Jophish/YM2612-Synth/YM2612/Ym2612.sch

## EAGLE design YM2612/Ym2612.sch (2020-07-03)

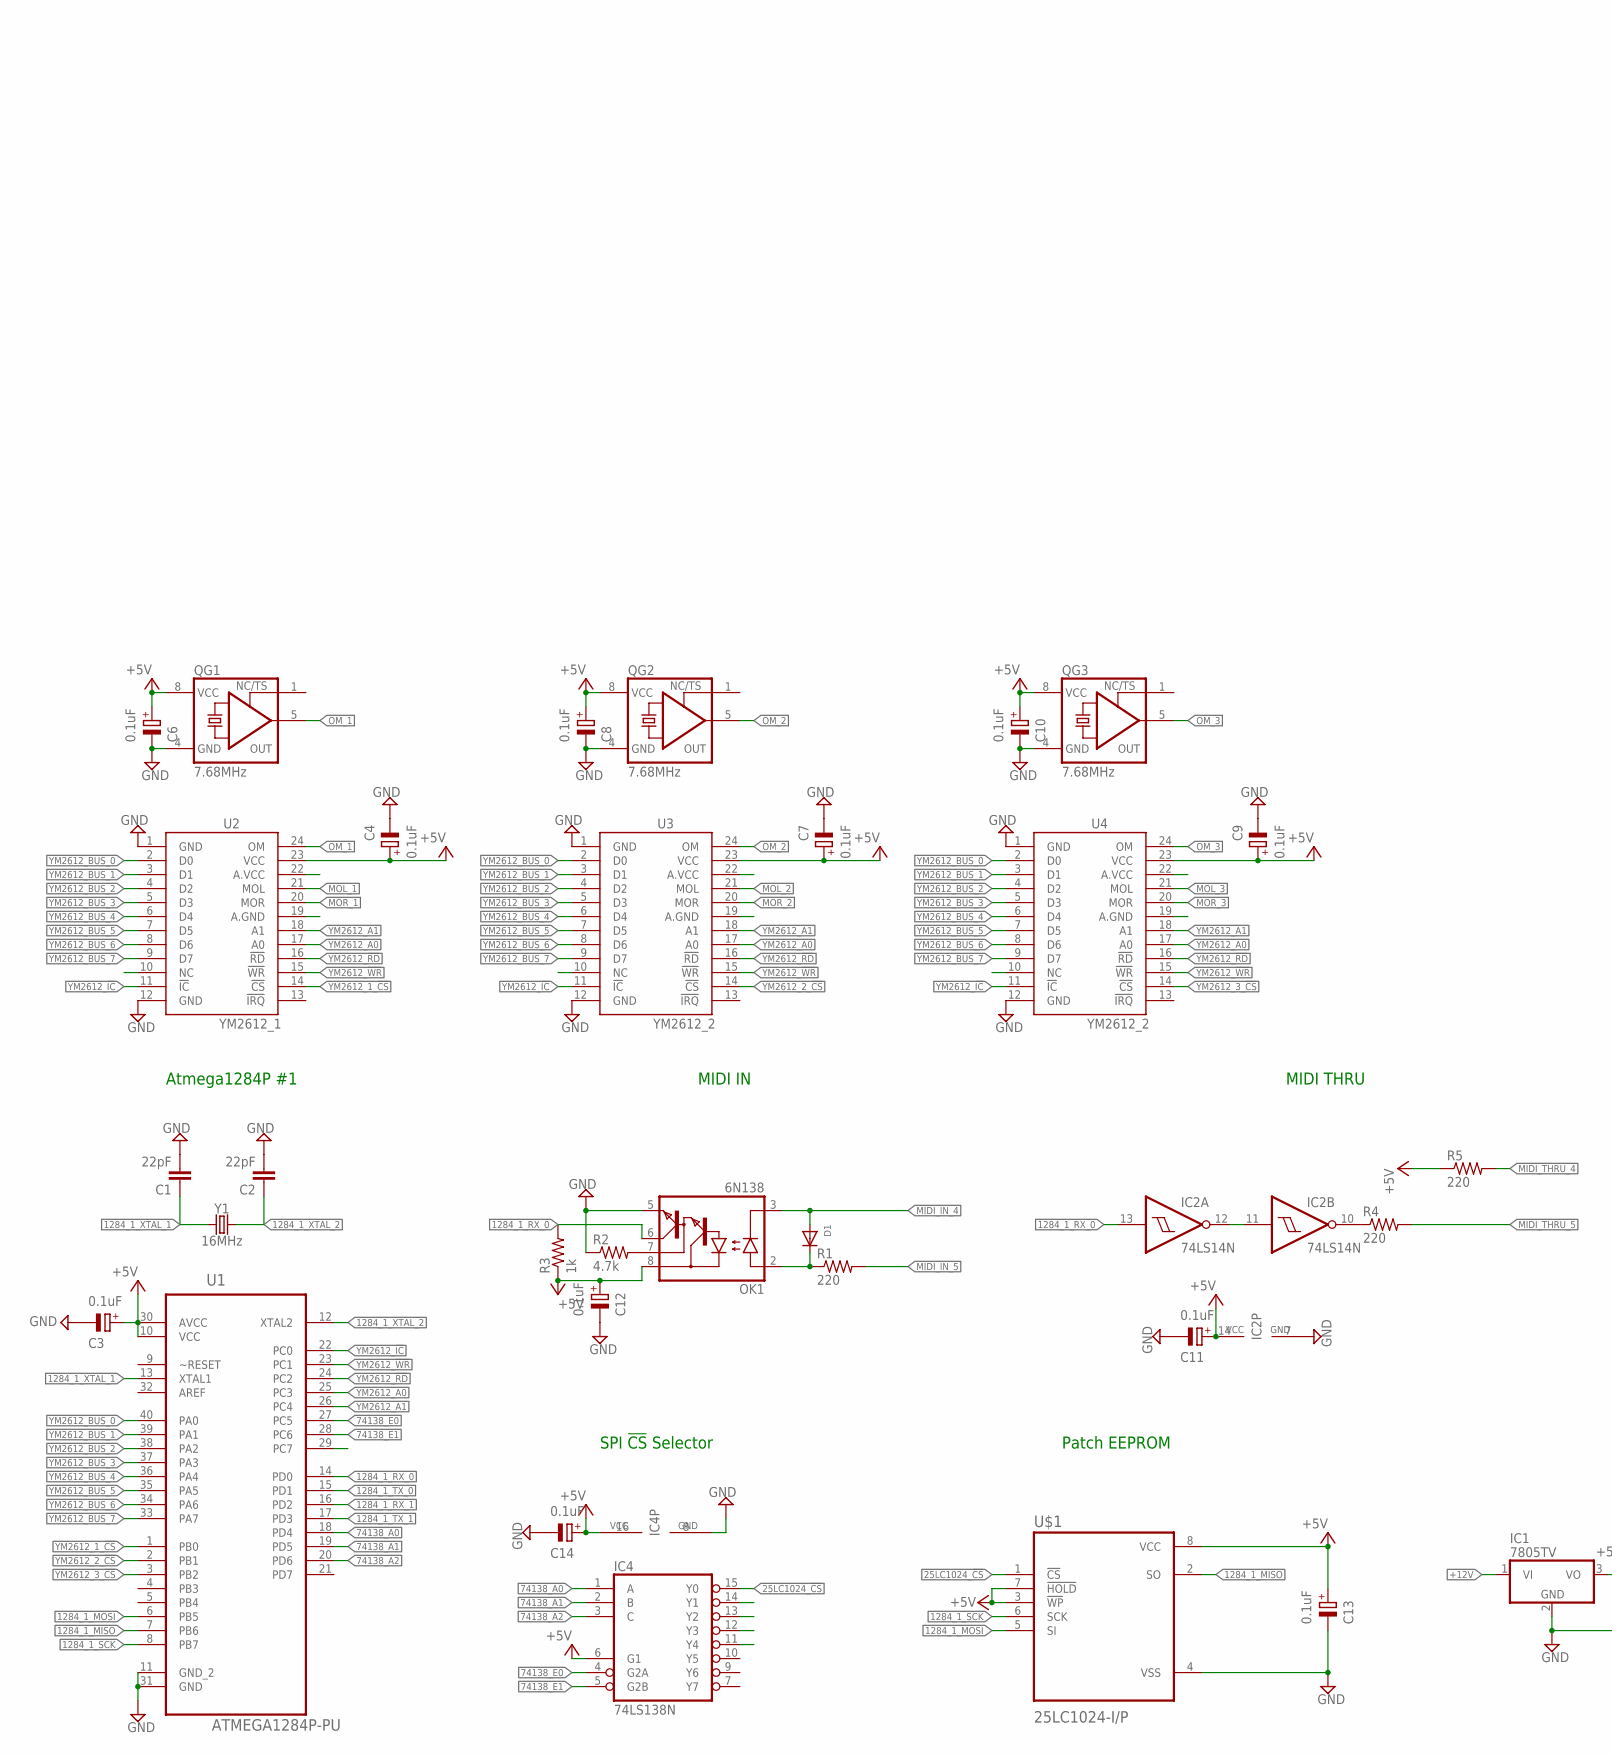
[picture p1: schematic Ym2612.sch, part in row 1, column 1]

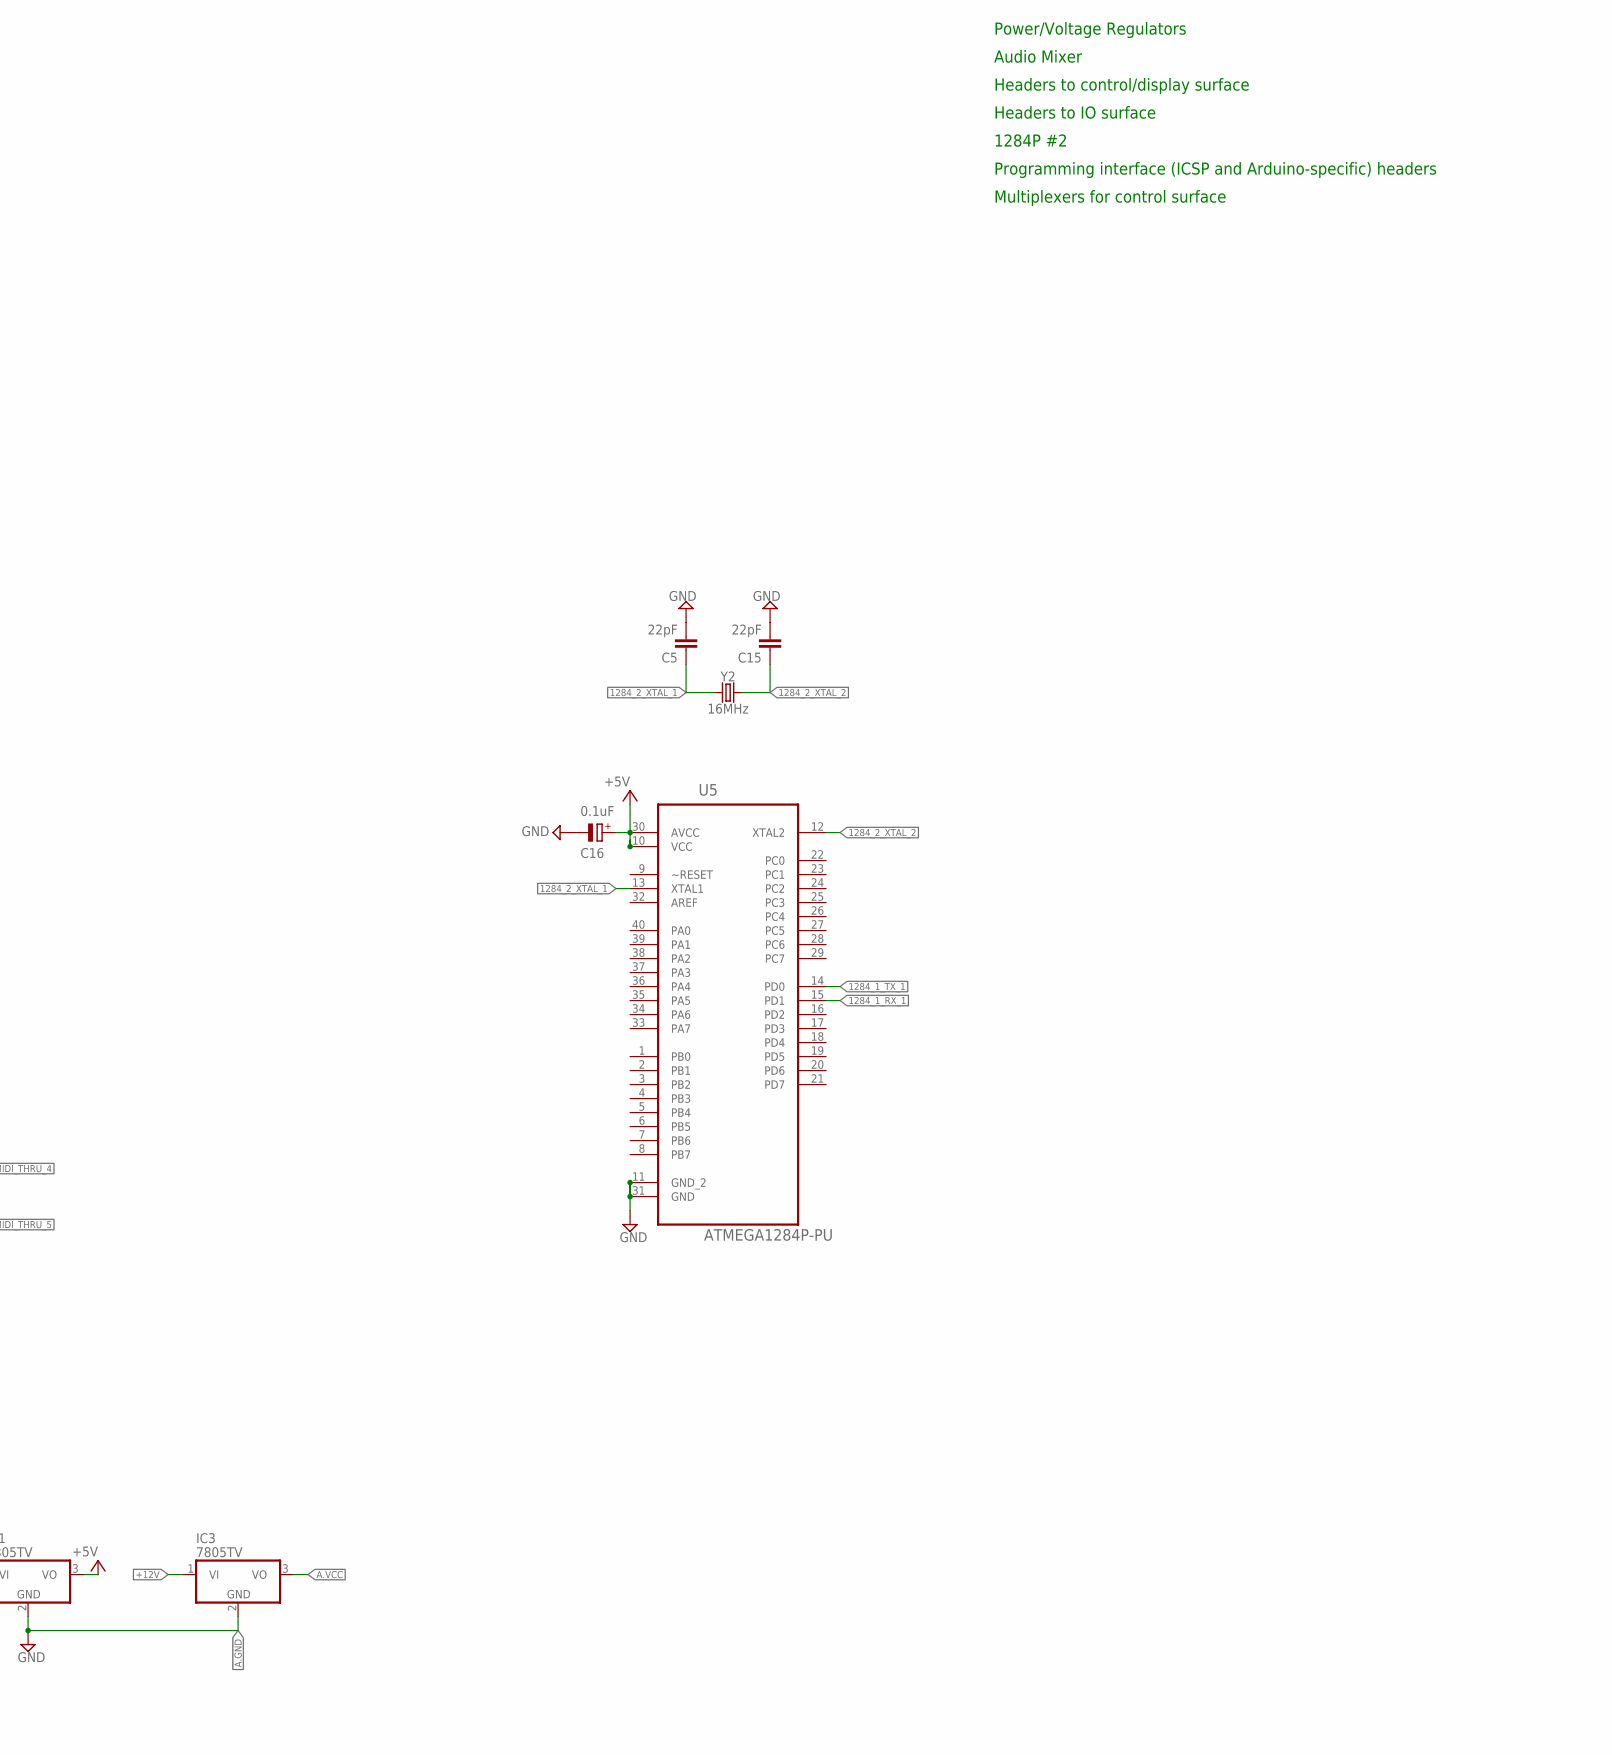
[picture p2: schematic Ym2612.sch, part in row 1, column 2]

Parts:
C1, C2, C5, C15: 22pF; C050-024X044
C3, C4, C6, C7, C8, C9, C10, C11, C12, C13, C14, C16: 0.1uF; E2,5-6
D1: DIODEDO-1N4148; DO-1N4148
IC1, IC3: 7805TV; TO220V
IC2: 74LS14N; DIL14
IC4: 74LS138N; DIL16
OK1: 6N138; DIL08
QG1, QG2, QG3: 7.68MHz; DIL08S
R1, R4, R5: 220; 0207/10
R2: 4.7k; 0207/10
R3: 1k; 0207/10
U1, U5: ATMEGA1284P-PU; DIP254P1524X483-40
U2: YM2612_1; DIP24
U3, U4: YM2612_2; DIP24
U$1: 25LC1024-I/P; DIP787W46P254L927H533Q8
Y1, Y2: 16MHz; HC49US

Connections:
25LC1024_!CS!: IC4.15 (Y0), U$1.1 (!CS)
1284_1_MISO: U1.7 (PB6), U$1.2 (SO)
1284_1_MOSI: U1.6 (PB5), U$1.5 (SI)
1284_1_RX_0: IC2.13 (I), OK1.6 (VO), R3.2, U1.14 (PD0)
1284_1_RX_1: U1.16 (PD2), U5.15 (PD1)
1284_1_SCK: U1.8 (PB7), U$1.6 (SCK)
1284_1_TX_0: U1.15 (PD1)
1284_1_TX_1: U1.17 (PD3), U5.14 (PD0)
1284_1_XTAL_1: C1.1, U1.13 (XTAL1), Y1.1
1284_1_XTAL_2: C2.1, U1.12 (XTAL2), Y1.2
1284_2_XTAL_1: C5.1, U5.13 (XTAL1), Y2.1
1284_2_XTAL_2: C15.1, U5.12 (XTAL2), Y2.2
74138_A0: IC4.1 (A), U1.18 (PD4)
74138_A1: IC4.2 (B), U1.19 (PD5)
74138_A2: IC4.3 (C), U1.20 (PD6)
74138_E0: IC4.4 (G2A), U1.27 (PC5)
74138_E1: IC4.5 (G2B), U1.28 (PC6)
+5V: C3.+, C4.+, C6.+, C7.+, C8.+, C9.+, C10.+, C11.+, C12.+, C13.+, C16.+, IC1.3 (VO), IC2.14 (VCC), IC4.6 (G1), OK1.8 (VCC), QG1.8 (VCC), QG2.8 (VCC), QG3.8 (VCC), R3.1, R5.1, U1.10 (VCC), U1.30 (AVCC), U2.23 (VCC), U3.23 (VCC), U4.23 (VCC), U5.10 (VCC), U5.30 (AVCC), U$1.3 (!WP), U$1.7 (!HOLD), U$1.8 (VCC)
+12V: IC1.1 (VI), IC3.1 (VI)
A.GND: IC1.2 (GND), IC3.2 (GND)
A.VCC: IC3.3 (VO)
GND: C1.2, C2.2, C3.-, C4.-, C5.2, C6.-, C7.-, C8.-, C9.-, C10.-, C11.-, C12.-, C13.-, C14.-, C15.2, C16.-, IC2.7 (GND), IC4.8 (GND), OK1.5 (GND), QG1.4 (GND), QG2.4 (GND), QG3.4 (GND), R2.1, U1.11 (GND_2), U1.31 (GND), U2.1 (GND), U2.12 (GND), U3.1 (GND), U3.12 (GND), U4.1 (GND), U4.12 (GND), U5.11 (GND_2), U5.31 (GND), U$1.4 (VSS)
MIDI_IN_4: D1.A, OK1.3 (C)
MIDI_IN_5: R1.2
MIDI_THRU_4: R5.2
MIDI_THRU_5: R4.2
MOL_1: U2.21 (MOL)
MOL_2: U3.21 (MOL)
MOL_3: U4.21 (MOL)
MOR_1: U2.20 (MOR)
MOR_2: U3.20 (MOR)
MOR_3: U4.20 (MOR)
unnamed: IC2.10 (O), R4.1
unnamed: D1.C, OK1.2 (A), R1.1
unnamed: IC2.11 (I), IC2.12 (O)
unnamed: OK1.7 (VB), R2.2
unnamed: C14.+, IC4.16 (VCC)
OM_1: QG1.5 (OUT), U2.24 (OM)
OM_2: QG2.5 (OUT), U3.24 (OM)
OM_3: QG3.5 (OUT), U4.24 (OM)
YM2612_1_!CS!: U1.1 (PB0), U2.14 (!CS!)
YM2612_2_!CS!: U1.2 (PB1), U3.14 (!CS!)
YM2612_3_!CS!: U1.3 (PB2), U4.14 (!CS!)
YM2612_!IC!: U1.22 (PC0), U2.11 (!IC!), U3.11 (!IC!), U4.11 (!IC!)
YM2612_!RD!: U1.24 (PC2), U2.16 (!RD!), U3.16 (!RD!), U4.16 (!RD!)
YM2612_!WR!: U1.23 (PC1), U2.15 (!WR!), U3.15 (!WR!), U4.15 (!WR!)
YM2612_A0: U1.25 (PC3), U2.17 (A0), U3.17 (A0), U4.17 (A0)
YM2612_A1: U1.26 (PC4), U2.18 (A1), U3.18 (A1), U4.18 (A1)
YM2612_BUS_0: U1.40 (PA0), U2.2 (D0), U3.2 (D0), U4.2 (D0)
YM2612_BUS_1: U1.39 (PA1), U2.3 (D1), U3.3 (D1), U4.3 (D1)
YM2612_BUS_2: U1.38 (PA2), U2.4 (D2), U3.4 (D2), U4.4 (D2)
YM2612_BUS_3: U1.37 (PA3), U2.5 (D3), U3.5 (D3), U4.5 (D3)
YM2612_BUS_4: U1.36 (PA4), U2.6 (D4), U3.6 (D4), U4.6 (D4)
YM2612_BUS_5: U1.35 (PA5), U2.7 (D5), U3.7 (D5), U4.7 (D5)
YM2612_BUS_6: U1.34 (PA6), U2.8 (D6), U3.8 (D6), U4.8 (D6)
YM2612_BUS_7: U1.33 (PA7), U2.9 (D7), U3.9 (D7), U4.9 (D7)

Notes on the sheet:
Atmega1284P #1
SPI !CS! Selector
Patch EEPROM
MIDI IN
MIDI THRU
Power/Voltage Regulators
Audio Mixer
Headers to control/display surface
Headers to IO surface
1284P #2
Programming interface (ICSP and Arduino-specific) headers
Multiplexers for control surface
