Jophish/YM2612-Synth/1284test/YM2612 Synth/untitled.sch

## EAGLE design 1284test/YM2612 Synth/untitled.sch (2018-06-13)

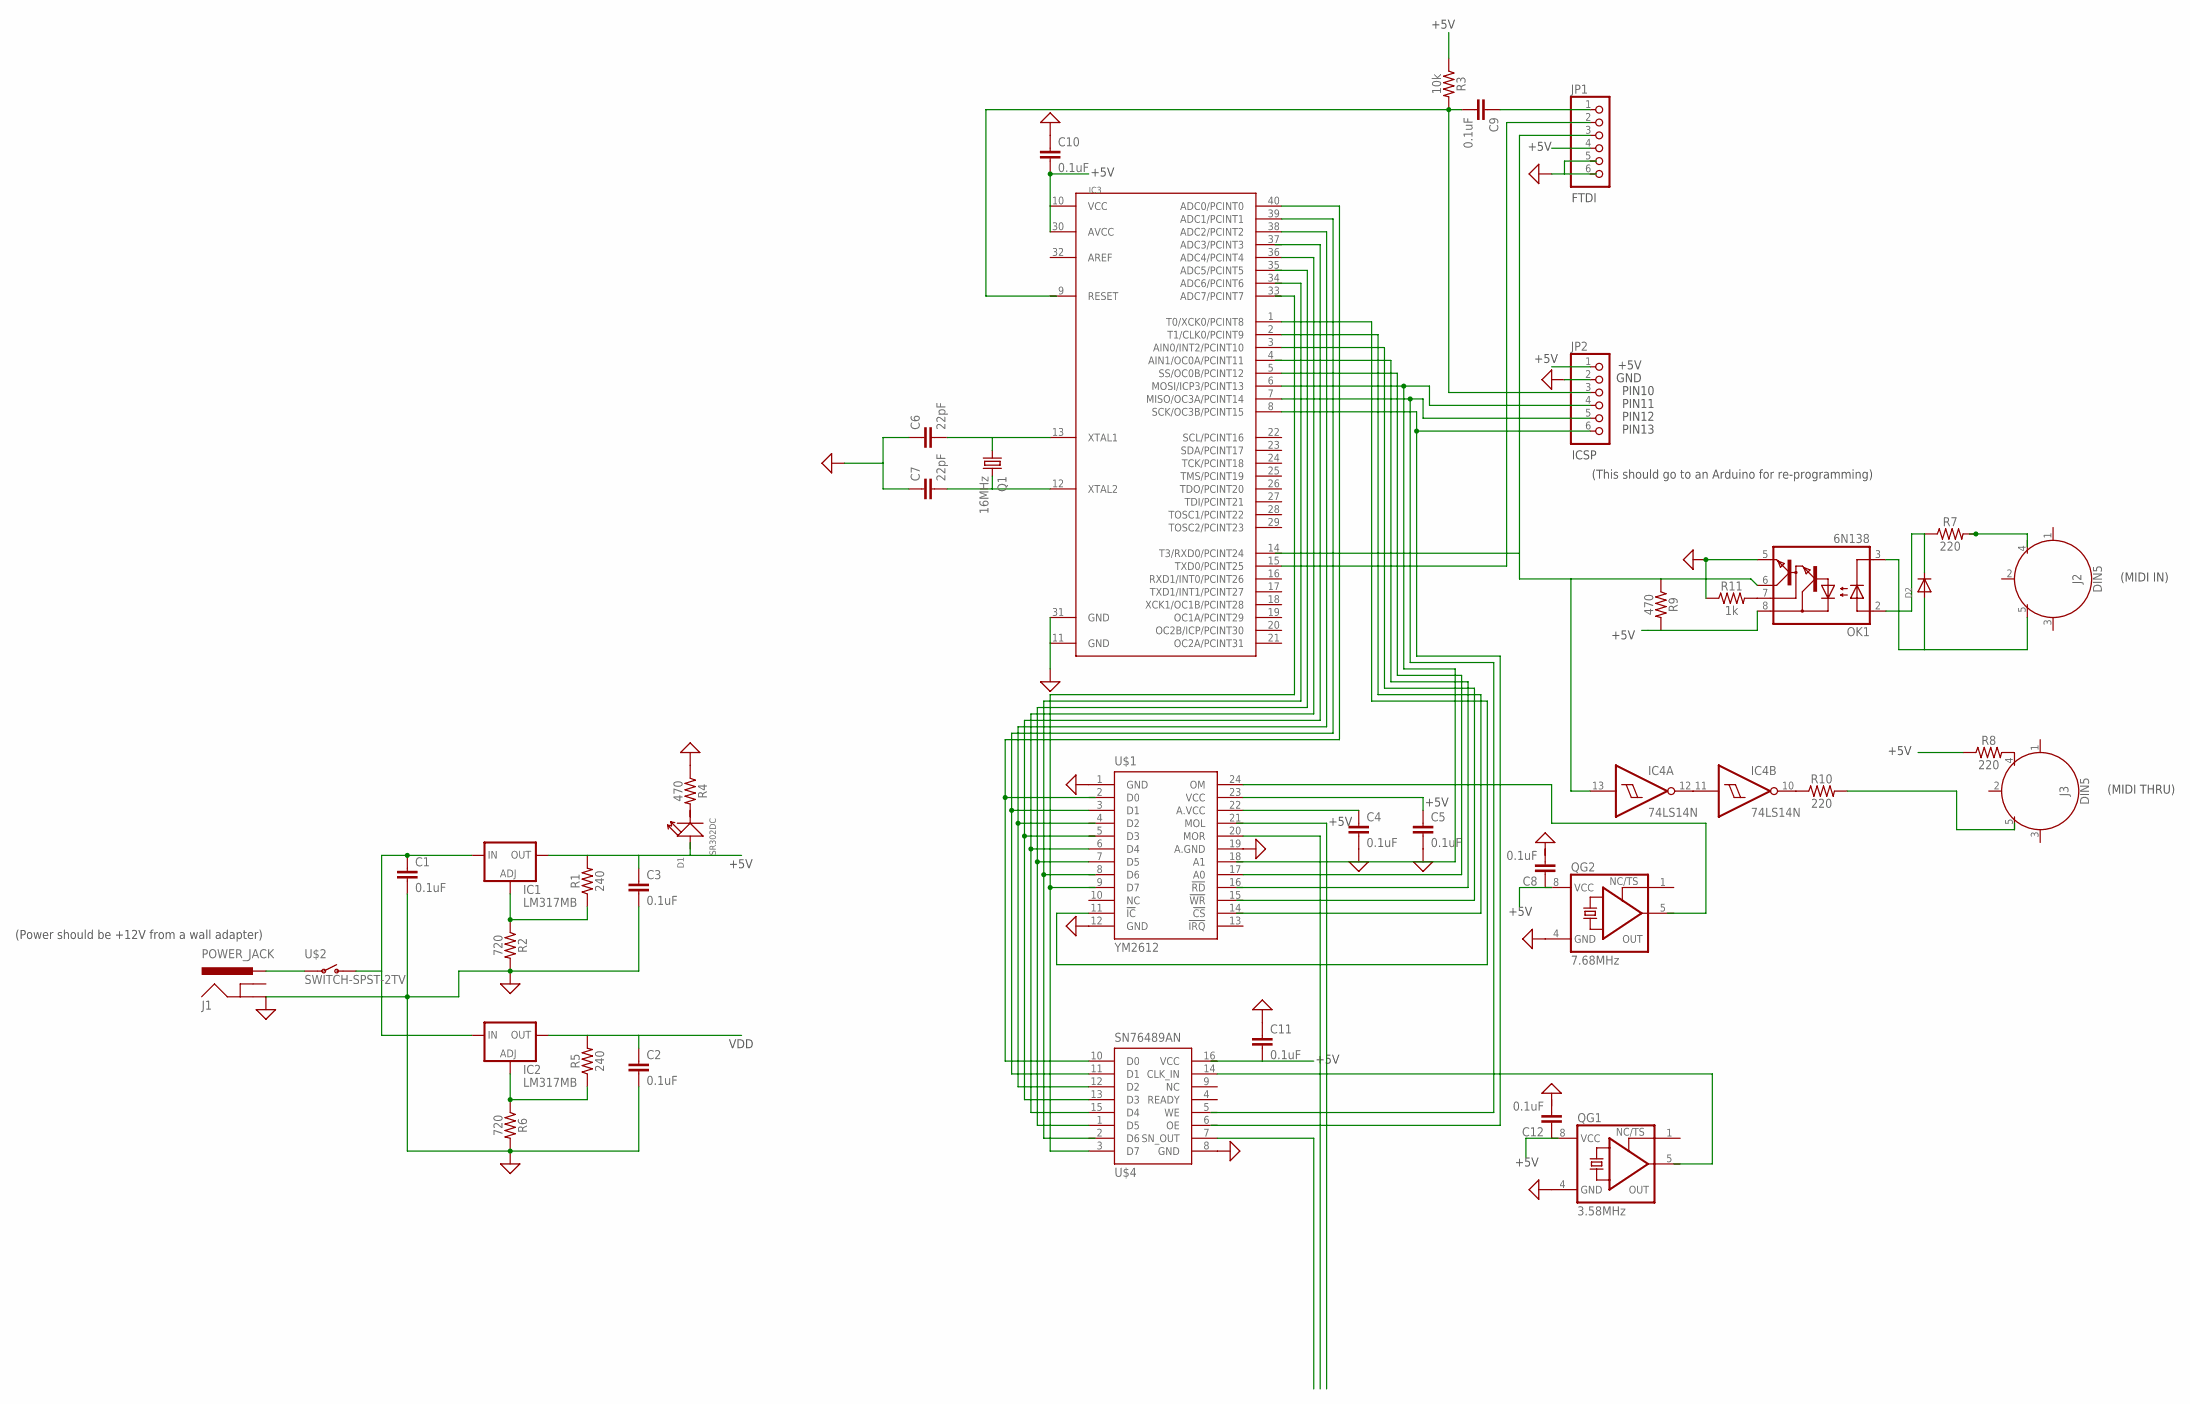
[picture p3: schematic untitled.sch]

Parts:
C1, C2, C3, C4, C5, C8, C9, C10, C11, C12: 0.1uF; 0402-CAP
C6, C7: 22pF; 0402-CAP
D1: SR302DC; LED2-2.54-D3.0MM
D2: DIODEDO-1N4148; DO-1N4148
IC1, IC2: LM317MB; TO220L1
IC3: MEGA1284P; DIL40
IC4: 74LS14N; DIL14
J1: POWER_JACK; POWER_JACK_PTH
J2, J3: DIN5; DIN5-RA-PTH
JP1, JP2: PINHD-1X6; 1X06
OK1: 6N138; DIL08
Q1: 16MHz; HC18U-H
QG1: 3.58MHz; DIL08S
QG2: 7.68MHz; DIL08S
R1, R5: 240; AXIAL-0.3
R2, R6: 720; AXIAL-0.3
R3: 10k; AXIAL-0.3
R4, R9: 470; AXIAL-0.3
R7, R8, R10: 220; AXIAL-0.3
R11: 1k; AXIAL-0.3
U$1: YM2612; DIP24
U$2: SWITCH-SPST-2TV; SWITCH-SPST-VERTICAL
U$4: SN76489AN; DIP16

Connections:
+5V: C3.1, C4.1, C5.1, C10.2, C11.2, IC1.2 (OUT), IC3.10 (VCC), IC3.30 (AVCC), JP1.4, JP2.1, OK1.8 (VCC), R1.P$2 (2), R3.P$1 (1), R8.P$1 (1), R9.P$2 (2), U$1.22 (A.VCC), U$1.23 (VCC)
GND: C1.2, C2.2, C3.2, C4.2, C5.2, C6.1, C7.1, C10.1, C11.1, IC3.11 (GND), IC3.31 (GND), J1.GND, JP2.2, OK1.5 (GND), QG1.4 (GND), QG2.4 (GND), R2.P$2 (2), R4.P$1 (1), R6.P$2 (2), R11.P$1 (1), U$1.1 (GND), U$1.12 (GND), U$1.19 (A.GND), U$4.8 (GND)
unnamed: C1.1, IC1.3 (IN), IC2.3 (IN), U$2.1 (O)
unnamed: C6.2, IC3.13 (XTAL1), Q1.1
unnamed: IC1.1 (ADJ), R1.P$1 (1), R2.P$1 (1)
unnamed: C7.2, IC3.12 (XTAL2), Q1.2
unnamed: J1.PWR, U$2.2
unnamed: C9.2, JP2.3, R3.P$2 (2)
unnamed: C9.1, JP1.1
unnamed: IC2.1 (ADJ), R5.P$1 (1), R6.P$1 (1)
unnamed: IC3.15 (TXD0/PCINT25), JP1.2
unnamed: IC4.13 (I), JP1.3, OK1.6 (VO), R9.P$1 (1)
unnamed: IC3.7 (MISO/OC3A/PCINT14), JP2.5
unnamed: IC3.6 (MOSI/ICP3/PCINT13), JP2.4
unnamed: IC3.8 (SCK/OC3B/PCINT15), JP2.6
unnamed: U$1.7 (D5), U$4.1 (D5)
unnamed: IC3.36 (ADC4/PCINT4), U$1.6 (D4), U$4.15 (D4)
unnamed: IC3.38 (ADC2/PCINT2), U$4.12 (D2)
unnamed: IC3.39 (ADC1/PCINT1), U$1.3 (D1), U$4.11 (D1)
unnamed: IC3.40 (ADC0/PCINT0), U$4.10 (D0)
unnamed: IC3.1 (T0/XCK0/PCINT8), U$1.11 (!IC!)
unnamed: IC3.5 (SS/OC0B/PCINT12), U$1.17 (A0)
unnamed: D2.A, J2.5, OK1.3 (C)
unnamed: D2.C, OK1.2 (A), R7.P$1 (1)
unnamed: OK1.7 (VB), R11.P$2 (2)
unnamed: IC4.11 (I), IC4.12 (O)
unnamed: IC4.10 (O), R10.P$1 (1)
unnamed: C8.1, QG2.8 (VCC)
unnamed: J3.5, R10.P$2 (2)
unnamed: J3.4, R8.P$2 (2)
unnamed: C12.1, QG1.8 (VCC)
VDD: C2.1, IC2.2 (OUT), R5.P$2 (2)

Notes on the sheet:
+5V
VDD
FTDI
ICSP
(This should go to an Arduino for re-programming)
GND
PIN10
PIN11
PIN12
PIN13
(Power should be +12V from a wall adapter)
(MIDI IN)
(MIDI THRU)
