Jophish/YM2612-Synth/(commit log)

2018-06-13 Added schematics
    [untitled.sch]
2020-06-26 New structure, new shcematic
    [Ym2612.sch, untitled.sch]
2020-07-03 Lots of work
    [Ym2612.sch]
